Scavenger18/RepoPNP/Documentation/5_CAD/Assemblies/readme.txt

The assemblies include all files used to create the 3D CAD models of the feeders.
These were exported directly from the assemblies in the onshape project.
These include more pieces than need to be printed, such as screws and motor parts.
