Scavenger18/RepoPNP/Documentation/6_PCB-Daten/KiCAD/readme.txt

Frühere Versionen welche für Prototypen verwendet wurden sind nicht beigelegt.

Master_Board
- Das PCB für den Master für tinyK22, Kommunikation und Speisung.

Wall_F_V5
- Erweiterung aller Anpassungen und Boardform für die Projektabgabe. (Nicht getestet)

Wall_B_V5
- Die Seitenwand ohne elektrische Funktion. Stand Projektabgabe. 

PROTOTYPEN

Wall_F_V2
- Prototypenversion, Falscher uC Footprint.

Wall_F_V3
- Einbindung Encoderboard. Die Version welche für den Prototypenbau bei PCBWay bestellt wurde.

Wall_F_V4
- Die Umsetzung von diversen Änderungen. (Nicht getestet)

Enc_Board_V0
- Prototyp für Hallsensoren und Motormontage

Enc_Board_V1
- Prototyp für Lichtschranke EESX1350 Omron, Freistehend

Enc_Board_V2
- Prototyp für Lichtschranke EESX1350 Omron, Montage auf Wall_F

Enc_Board_v3
- Änderung des Footprints, Einbindung in Wall_F

H-Bridge_Board_V1
- Testaufbau für H-Brücke und Hallsensoren
