Scavenger18/RepoPNP/Documentation/6_PCB-Daten/CAM_Files/Sprocket/readme.txt

Folgend werden die in diesem Ordner vorhanden CAM-Dateien aufgelistet.
Die wall-Dateien können aus den jeweiligen KiCAD Projekten entnommen werden.

Sprocket_V2
- Innerer Bohrungsdurchmesser 3 mm
- Lichtschrankenbohrungen 23 mil

Sprocket_V3
- Innerer Bohrungsdurchmess 6.1 mm
- Lichtschrankenbohrungen 24 mil

Master_V1
- Stand Master PCB bei Projektabgabe

SeitenWand_V3
- Einseitig zu produzierendes PCB für die unbestückte Seitenwand des Feeders
