Scavenger18/RepoPNP/Documentation/4_3D-Daten/Normal settings.txt

Normal:
layer height: 0.1 mm
shell thickness: 0.4 mm
bottom/top thickness: 0.4 mm
fill density: 20%
