Scavenger18/RepoPNP/Documentation/5_CAD/Onshape_Projectlink.txt

Das OnShape Projekt kann unter dem Namen PnP-Feeder PAIND vom Benutzer s_h039 gefunden werden.

https://cad.onshape.com/documents/ed19ce3a0a41ba7e1ba1ae9e/w/841fa937de2a0d8fdfc5e5b4/e/0f40a22ce323581e1e362835
