Scavenger18/RepoPNP/CAD/images/Feeder_End_Radius.PNG

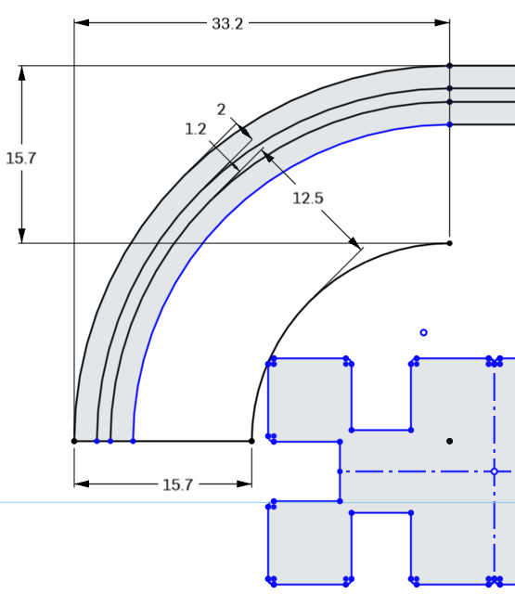
CAD/images/Feeder_End_Radius.PNG
