Scavenger18/RepoPNP/Datasheets/alu_schiene4020.jpg

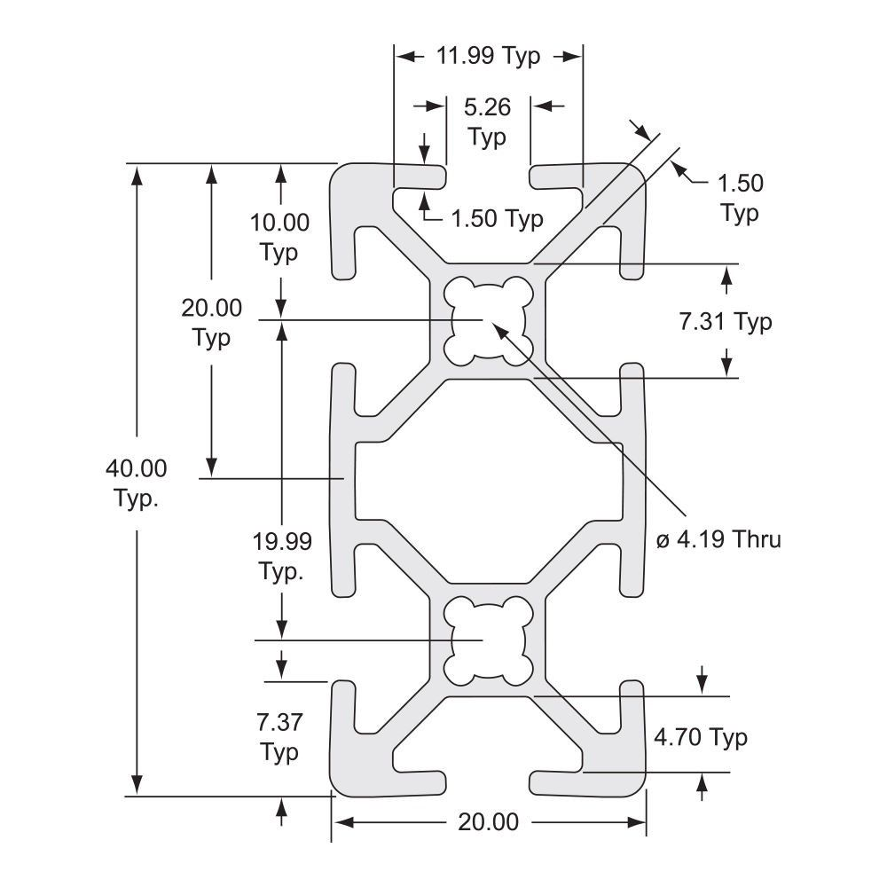
Datasheets/alu_schiene4020.jpg
