Scavenger18/RepoPNP/Datasheets/feedingfrenzy_schematic.png

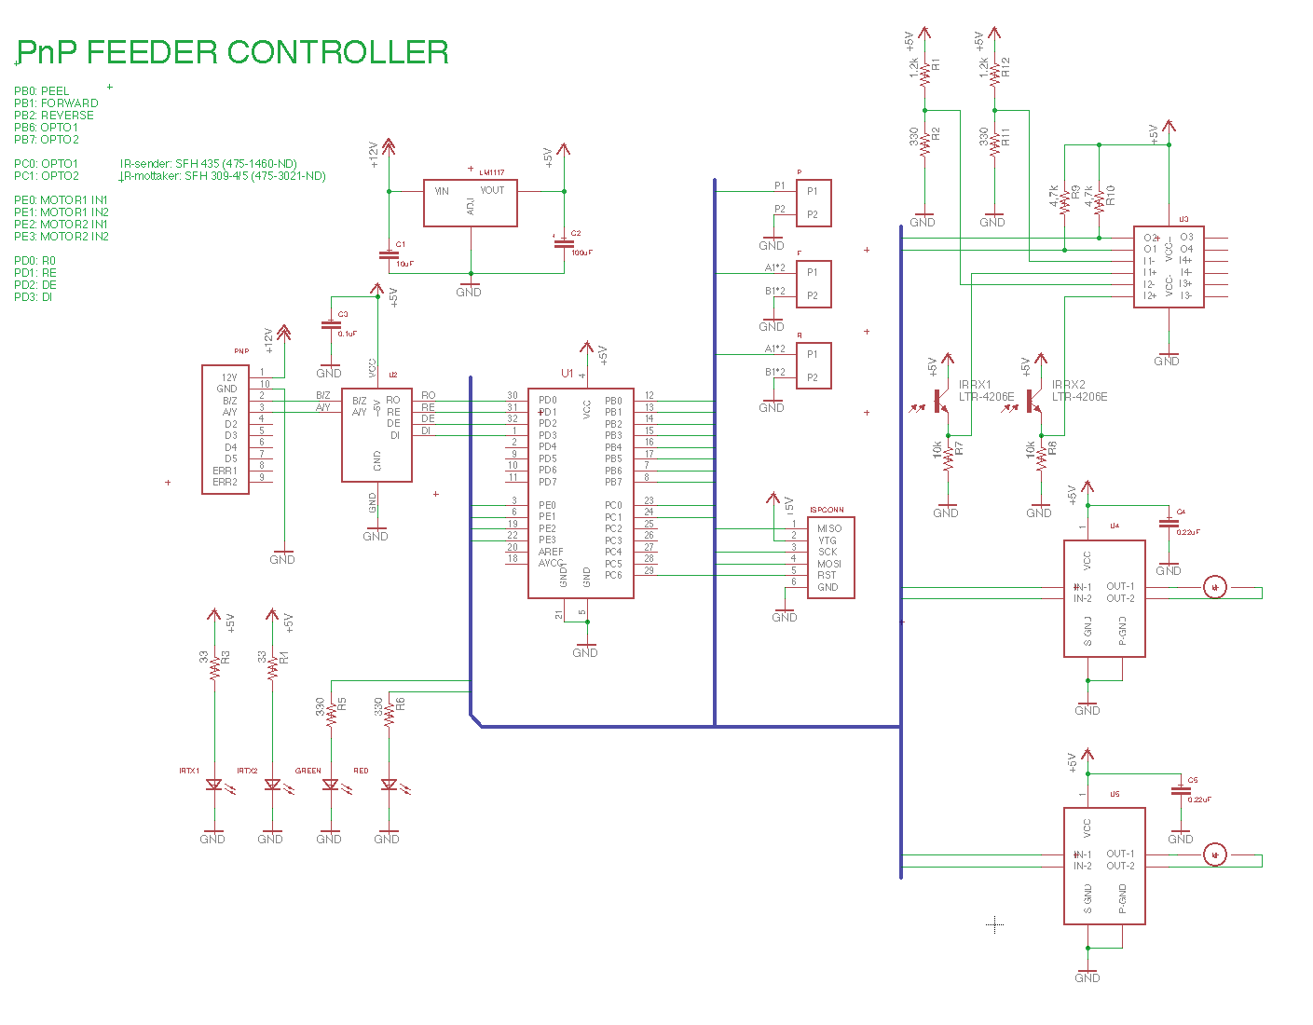
Datasheets/feedingfrenzy_schematic.png
