Scavenger18/RepoPNP/Datasheets/n20_gearmotor.jpg

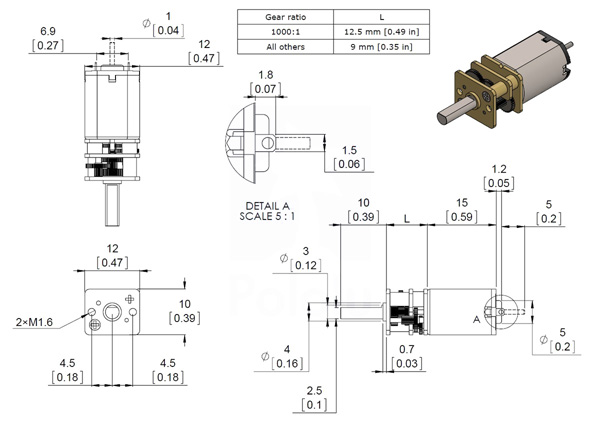
Datasheets/n20_gearmotor.jpg
