Scavenger18/RepoPNP/Documentation/1_Projektmanagement/Kostenzusammenstellung.xlsx

Sheet: Feeder
Kostenzusammenstellung PnP Feeder
Es wurden die Gesamtkosten für 50 Feeder berechnet, wenn alle Komponenten extern beschafft werden.
Die Unterschiede von Kosten zwischen den Feedern wurden gemittelt.
Die Preise wurden zwischen April und Juni 2018 von den Lieferantenwebseiten entnommen.
Exkl. Versandkosten
Position | Bereich | Artikelname | Bestellnummer | Lieferant | Anzahl pro Feeder | Anzahl 50 Feeder | Kosten 50 Feeder | Kosten Stk. Mengenrabatt | Bemerkung
1 | Elektro | 2x5 Pin Sockel (SWD) | 649-202112100010C4LF | Mouser | 1 | 50 | 29.70 | 0.594
2 | Elektro | DC-Getriebemotoren 150:1 | G4F3CD2FC5F5E2 | TinySine | 2 | 100 | 500.00 | 5.000
3 | Elektro | Detektorschalter | 667-ESE-22MH57 | Mouser | 1 | 50 | 25.90 | 0.518
4 | Elektro | Einweglichtschranke | 653-EESX1350 | Mouser | 1 | 50 | 70.00 | 1.400
5 | Elektro | Federleiste DIN 41651, Female | 143-12-170 | Distrelec | 2 | 100 | 114.00 | 1.140
6 | Elektro | Ferrit 330 Ohm | 810-MPZ2012S331A | Mouser | 1 | 50 | 4.95 | 0.099
7 | Elektro | H-Brücke DRV8835 | 595-DRV8835DSSR | Mouser | 1 | 50 | 75.50 | 1.510
8 | Elektro | Kondensator 100nF | 710-885012207098 | Mouser | 9 | 450 | 18.90 | 0.042
9 | Elektro | Kondensator 1uF | 77-VJ0805Y105MXQTBC | Mouser | 1 | 50 | 1.90 | 0.038
10 | Elektro | Kondensator 2.2uF | 810-C2012JB1A225K08A | Mouser | 3 | 150 | 7.65 | 0.051
11 | Elektro | Kondensator 220uF | 140-VZL221M1CTR-0607 | Mouser | 2 | 100 | 13.60 | 0.136
12 | Elektro | Kondensator 330nF | 77-VJ0805Y334MXJTBC | Mouser | 2 | 100 | 3.10 | 0.031
13 | Elektro | LDO Spannungsregler | 579-TC1262-3.3VDBTR | Mouser | 1 | 50 | 22.35 | 0.447
14 | Elektro | LED Orange | 720-LOR976-PS-1 | Mouser | 1 | 50 | 9.35 | 0.187
15 | Elektro | Mikrokontroller MK20 | 841-MK20DX128VFT5 | Mouser | 1 | 50 | 229.50 | 4.590
16 | Elektro | Quarz 32.768kHz | 520-.327-CDX-1082 | Mouser | 1 | 50 | 26.35 | 0.527
17 | Elektro | Quarz 8 MHz | 774-406I35D08M00000 | Mouser | 1 | 50 | 28.95 | 0.579
18 | Elektro | Shottky Dioden | 821-BAS40-05 | Mouser | 1 | 50 | 15.50 | 0.310
19 | Elektro | SMD Taster | 612-LL3301NF065QG | Mouser | 3 | 150 | 69.00 | 0.460
20 | Elektro | Stiftleiste DIN 41651, Male | 143-65-383 | Distrelec | 2 | 100 | 123.00 | 1.230
21 | Elektro | Transistor BC847 | 863-BC847CLT1G | Mouser | 1 | 50 | 5.00 | 0.100
22 | Elektro | Widerstand 0 Ohm | 300-56-850 | Distrelec | 2 | 100 | 1.42 | 0.014
23 | Elektro | Widerstand 10 kOhm | 300-56-854 | Distrelec | 2 | 100 | 1.42 | 0.014
24 | Elektro | Widerstand 100 kOhm | 300-56-855 | Distrelec | 3 | 150 | 2.13 | 0.014
25 | Elektro | Widerstand 100 Ohm | 300-38-263 | Distrelec | 1 | 50 | 0.71 | 0.014
26 | Elektro | Widerstand 4.7 kOhm | 300-56-891 | Distrelec | 1 | 50 | 0.71 | 0.014
27 | Elektro | Widerstand 47 Ohm | 300-56-894 | Distrelec | 1 | 50 | 0.71 | 0.014
28 | Elektro | Widerstand 470 Ohm | 300-56-890 | Distrelec | 1 | 50 | 0.71 | 0.014
29 | mech. | Abstandsbolzen | *siehe Bemerkung | Distrelec | 2 | 100 | 50.00 | 0.500 | Gemittelter Preis
30 | mech. | Distanzstück 15 mm | 300-70-978 | Distrelec | 1 | 50 | 66.50 | 1.330
31 | mech. | PLA Material | ~28 gramm/feeder | 3d-printerstore | 1 | 50 | 31.50 | 0.630 | 22.50/kg
32 | PCB | PCB Feeder |  | PCBWay | 1 | 50 | 142.00 | 2.840
33 | PCB | PCB Seitenwand |  | PCBWay | 1 | 50 | 142.00 | 2.840
34 | PCB | Sprocket |  | PCBWay | 1 | 50 | 43.00 | 0.860
 |  |  |  |  |  | Total | 1877.01 | 37.5402

Sheet: Master
Kostenzusammenstellung PnP Master-Board
Es wurden die Gesamtkosten für 1 Master berechnet.
Das tinyK22 welches benötigt wird ist in dieser Zusammenstellung nicht miteinbezogen.
Position | Bereich | Artikelname | Bestellnummer | Lieferant | Anzahl pro Master | Kosten pro Stück | Kosten pro Master | Bemerkung
1 | Elektro | Stiftleiste DIN 41651, Male | 143-65-383 | Distrelec | 2 | 1.58 | 3.16
1 | Elektro | DC Power Jack, Female, 6.4 mm | 300-09-339 | Distrelec | 1 | 2.05 | 2.05
1 | PCB | PCB Master |  | PCBWay | 1 | 0.5 | 0.5 | 10 Stück
1 | mech. | PLA Material | ~21 gramm/master | 3d-printerstore | 1 | 0.4725 | 0.4725 | 22.50/kg
 |  |  |  |  |  | Total | 6.1825
