Scavenger18/RepoPNP/Documentation/1_Projektmanagement/Risikomanagement.xlsx

Sheet: Risikoliste
Risikoanalyse PnP Feeder
Titel | Beschreibung | Schadensart | W.-keit | Schadenshöhe | Risikoklasse | Massnahmen
Terminplan | Schlechte Zeiteinteilung | Zeitverlust | 30% | 20% | tragbar | Zeitpuffer einplanen
Dokumentation | Dokumentation/Arbeitsjournal vernachlässigen | Datenverlust | 30% | 40% | hoch | Jede Woche nachführen
Wartezeiten | Wartezeiten auf Bauteil-Bestellungen | Zeitverlust | 40% | 50% | sehr hoch | früh bestellen
falsche Strategie | Falsche Herangehensweise | Zeitverlust | 10% | 50% | hoch | Wöchentliche Sitzungen
mechanisches Konzept | Grobe Fehler in Prototypen | Konzeptänderung | 40% | 60% | sehr hoch | Konzeptbesprechung, ausführliche Tests
elektrisches Konzept | Grobe Fehler in Prototypen | Konzeptänderung | 30% | 60% | sehr hoch | Konzeptbesprechung, ausführliche Tests
Entwicklung PCB | Fehler in bestellten Leiterplatten | Zeitverlust | 20% | 50% | hoch | Vorgänger testen und Änderungen prüfen
Schritterkennung | Schrittverlust | nichterfüllung Vorgabe | 20% | 70% | sehr hoch | grosse Bohrungen, ausführliche Tests
3D Getriebe | Qualität und Funktion ungenügend | Konzeptänderung | 20% | 40% | hoch | früh testen und bestätigen
Kommunikation | Kommunikation an Feederbank scheitert | nichterfüllung Vorgabe | 20% | 50% | hoch | Distanzen kurz halten
Ungenauigkeit | mechanische Toleranzen führen zu ungenauen Schritte | nichterfüllung Vorgabe | 50% | 30% | sehr hoch | höchste Druckqualität verwenden
Bauteilverlust | Bauteile werden aus der Führung gespickt | Konzeptänderung | 20% | 30% | tragbar | Peeler sanft fahren, Deckel

Sheet: Matrixdefinition
Matrixaufbau
Wahrscheinlichkeit | Schadenshöhe | Risikoklasse | Einstufung | Matrix | 10 | 20 | 30 | 40 | 50 | 60 | 70 | 80 | 90 | 100
100% | 10% | 10 | kritisch | 10 | 1 | 2 | 3 | 4 | 5 | 6 | 7 | 8 | 9 | 10
90% | 20% | 9 | kritisch | 20 | 2 | 3 | 4 | 5 | 6 | 7 | 8 | 9 | 10 | 10
80% | 30% | 8 | sehr hoch | 30 | 3 | 4 | 5 | 6 | 7 | 8 | 9 | 10 | 10 | 10
70% | 40% | 7 | sehr hoch | 40 | 4 | 5 | 6 | 7 | 8 | 8 | 10 | 10 | 10 | 10
60% | 50% | 6 | hoch | 50 | 5 | 6 | 7 | 8 | 8 | 10 | 10 | 10 | 10 | 10
50% | 60% | 5 | hoch | 60 | 6 | 7 | 8 | 8 | 10 | 10 | 10 | 10 | 10 | 10
40% | 70% | 4 | tragbar | 70 | 7 | 8 | 9 | 10 | 10 | 10 | 10 | 10 | 10 | 10
30% | 80% | 3 | tragbar | 80 | 8 | 9 | 10 | 10 | 10 | 10 | 10 | 10 | 10 | 10
20% | 90% | 2 | klein | 90 | 9 | 10 | 10 | 10 | 10 | 10 | 10 | 10 | 10 | 10
10% | 100% | 1 | vernachlässigbar | 100 | 10 | 10 | 10 | 10 | 10 | 10 | 10 | 10 | 10 | 10
