Scavenger18/RepoPNP/Documentation/4_3D-Daten/0_Common/Normal/Sproc_Bot_Motor.stl

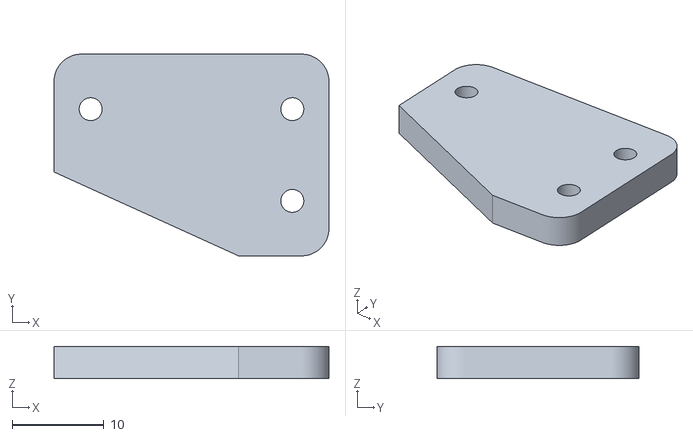
[picture p82: CAD file, 2018-06-06]
Documentation/4_3D-Daten/0_Common/Normal/Sproc_Bot_Motor.stl
30.0 x 22.0 x 3.50
