Scavenger18/RepoPNP/Documentation/4_3D-Daten/1_8MM/TapeGear_10_8MM.stl

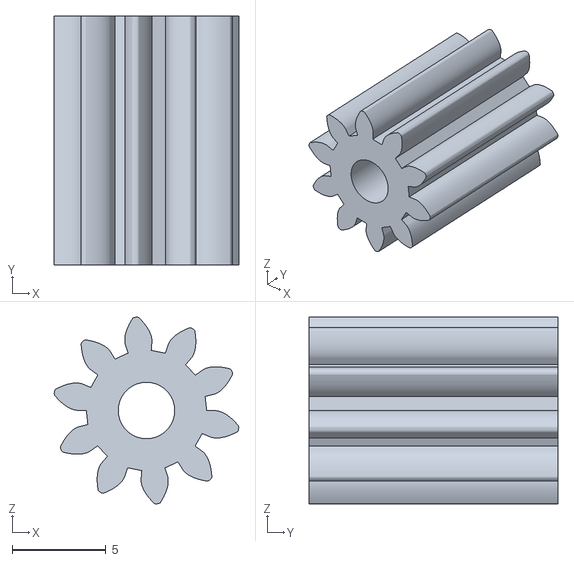
[picture p83: CAD file, 2018-06-06]
Documentation/4_3D-Daten/1_8MM/TapeGear_10_8MM.stl
9.83 x 13.3 x 9.95
