Scavenger18/RepoPNP/Documentation/4_3D-Daten/2_12MM/TapeGear_11_12MM.stl

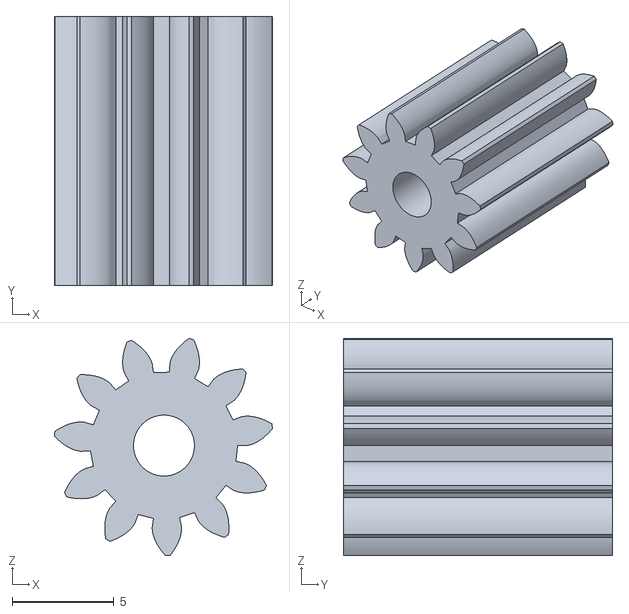
[picture p84: CAD file, 2018-06-06]
Documentation/4_3D-Daten/2_12MM/TapeGear_11_12MM.stl
10.8 x 13.3 x 10.7
