Scavenger18/RepoPNP/Documentation/4_3D-Daten/3_16MM/TapeGear_10_16mm.stl

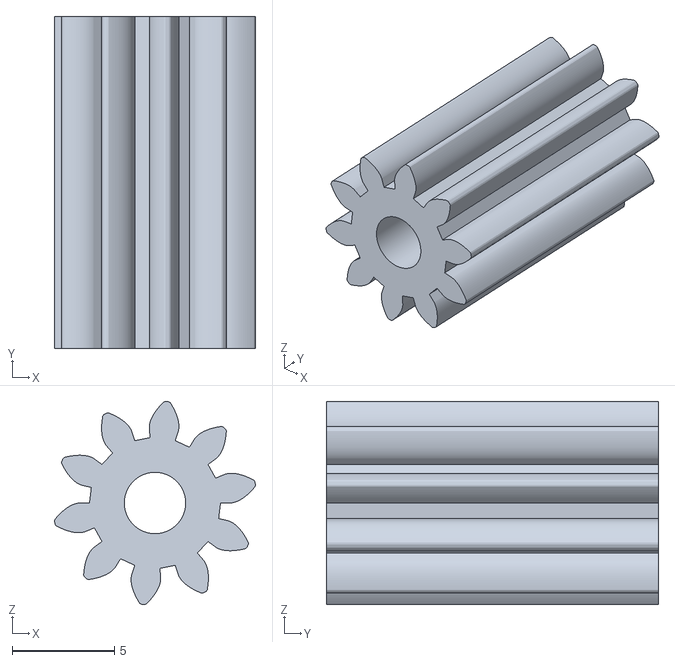
[picture p85: CAD file, 2018-06-06]
Documentation/4_3D-Daten/3_16MM/TapeGear_10_16mm.stl
9.84 x 16.2 x 9.94
