Scavenger18/RepoPNP/Documentation/4_3D-Daten/4_24MM/FrontWall_24MM.stl

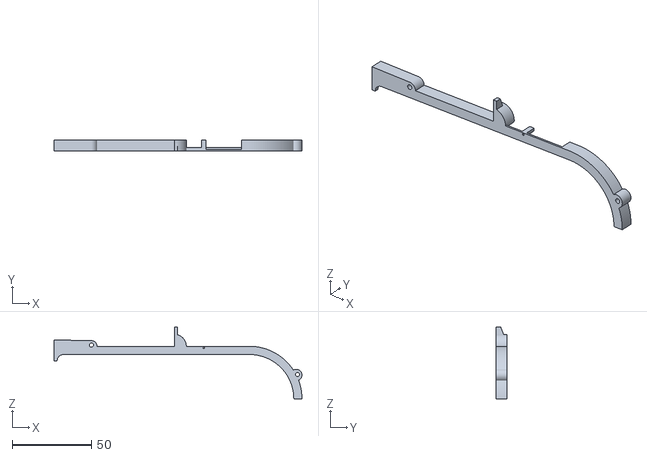
[picture p86: CAD file, 2018-06-06]
Documentation/4_3D-Daten/4_24MM/FrontWall_24MM.stl
156.6 x 7.00 x 45.3
