Scavenger18/RepoPNP/Documentation/4_3D-Daten/5_Mastergehäuse/MasterBox_Top.stl

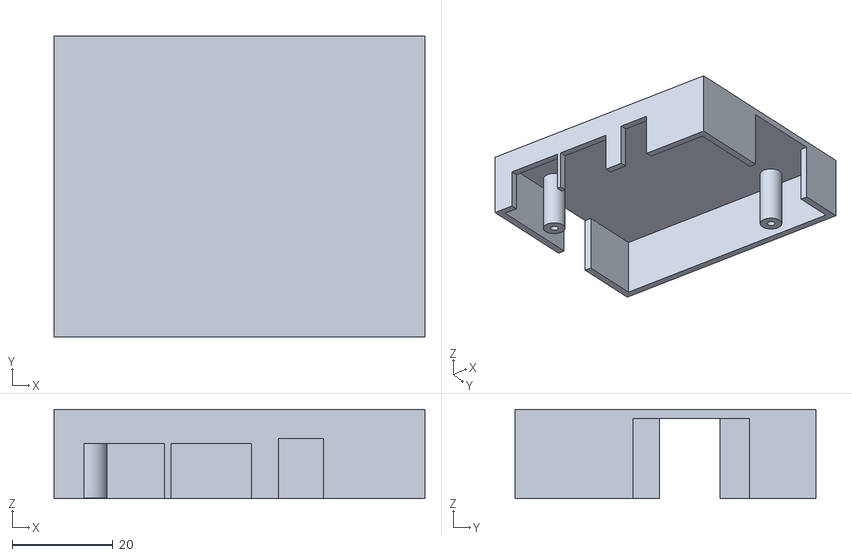
[picture p87: CAD file, 2018-06-06]
Documentation/4_3D-Daten/5_Mastergehäuse/MasterBox_Top.stl
73.5 x 59.6 x 17.7
