Scavenger18/RepoPNP/Documentation/5_CAD/DXF/Sprocket_62.dxf

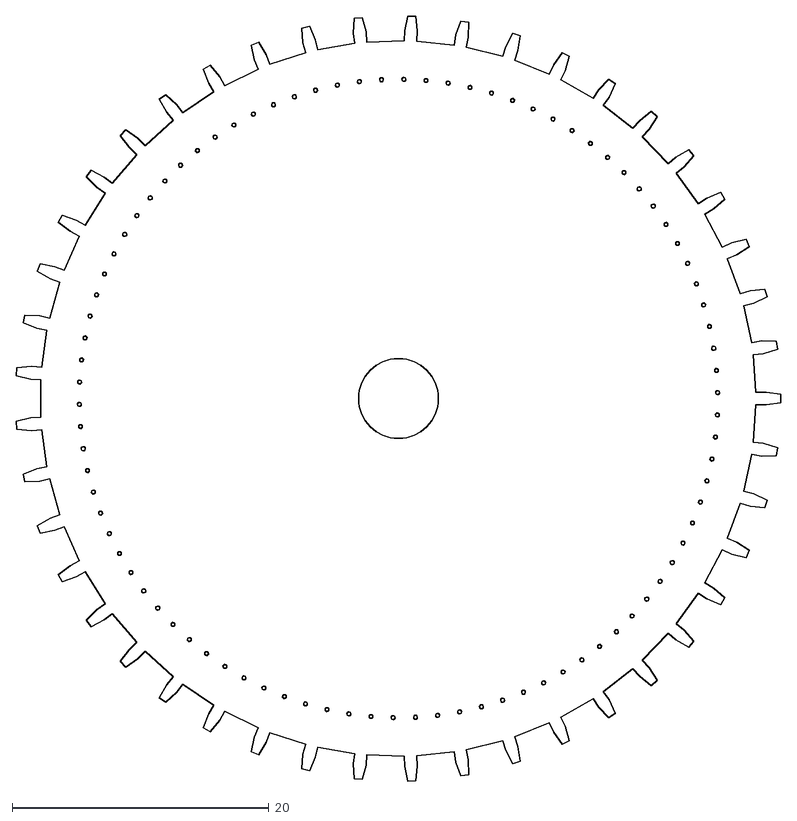
[picture p88: CAD file, 2018-06-06]
Documentation/5_CAD/DXF/Sprocket_62.dxf
59.5 x 59.5
