Scavenger18/RepoPNP/Documentation/4_3D-Daten/0_Common/Fine/SprocWorm_L.stl

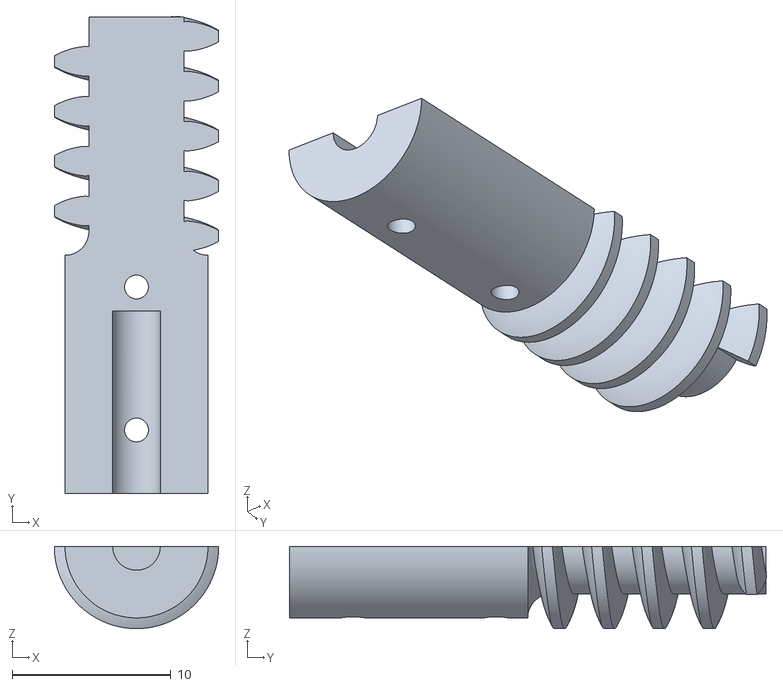
[picture p89: CAD file, 2018-06-06]
Documentation/4_3D-Daten/0_Common/Fine/SprocWorm_L.stl
10.4 x 30.0 x 5.18
