Scavenger18/RepoPNP/Documentation/4_3D-Daten/1_8MM/FrontWall_8MM.stl

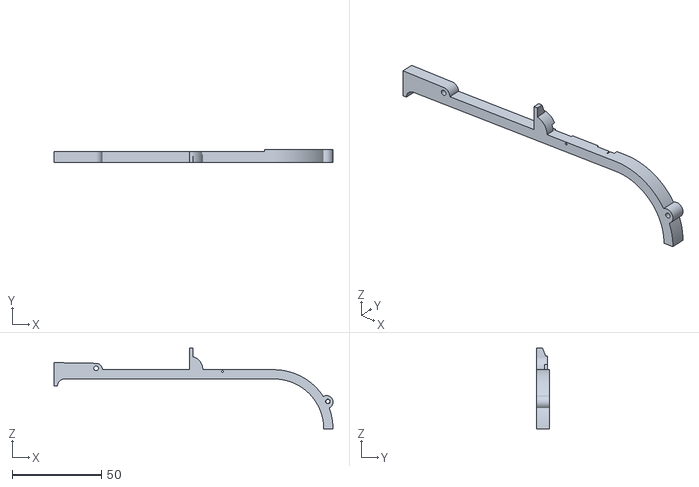
[picture p91: CAD file, 2018-06-06]
Documentation/4_3D-Daten/1_8MM/FrontWall_8MM.stl
156.6 x 7.50 x 45.3
