Scavenger18/RepoPNP/Documentation/4_3D-Daten/2_12MM/FrontWall_12MM.stl

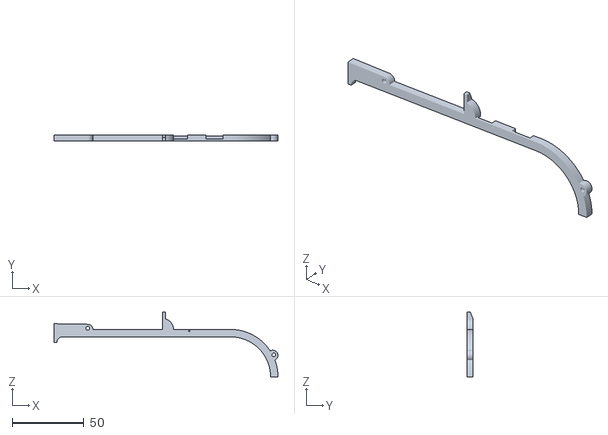
[picture p92: CAD file, 2018-06-06]
Documentation/4_3D-Daten/2_12MM/FrontWall_12MM.stl
156.6 x 4.50 x 45.3
