Scavenger18/RepoPNP/Documentation/4_3D-Daten/3_16MM/BackWall_16MM.stl

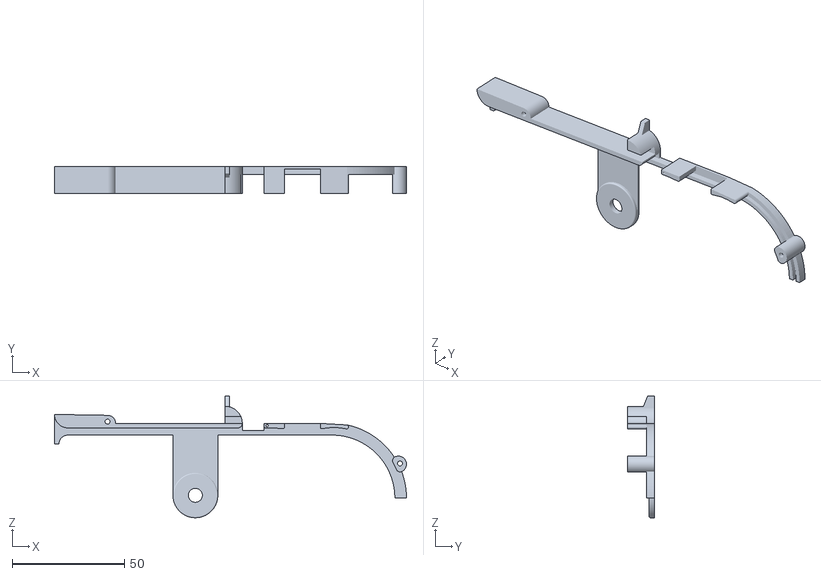
[picture p93: CAD file, 2018-06-06]
Documentation/4_3D-Daten/3_16MM/BackWall_16MM.stl
156.6 x 11.8 x 54.1
