Scavenger18/RepoPNP/Documentation/4_3D-Daten/4_24MM/TG_11_24mm.stl

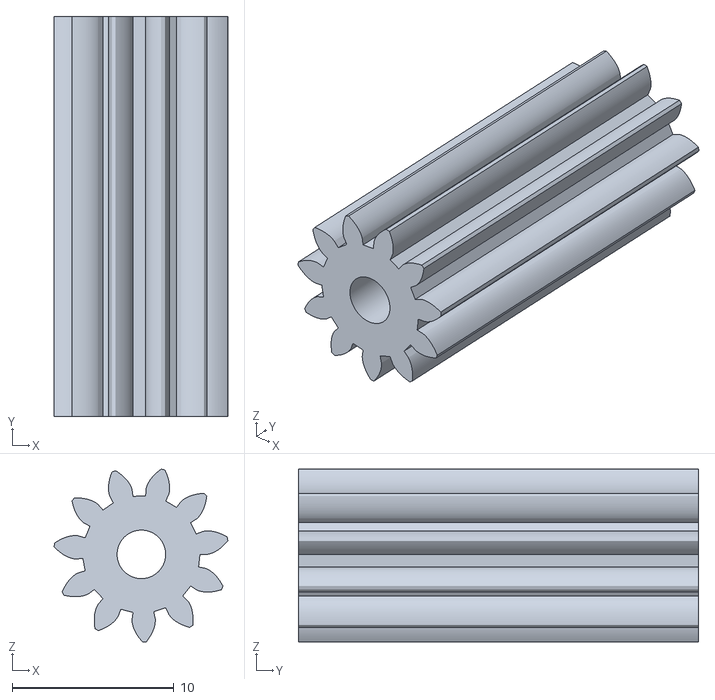
[picture p94: CAD file, 2018-06-06]
Documentation/4_3D-Daten/4_24MM/TG_11_24mm.stl
10.8 x 24.8 x 10.7
