Scavenger18/RepoPNP/Documentation/4_3D-Daten/5_Mastergehäuse/MasterBox_Bottom.stl

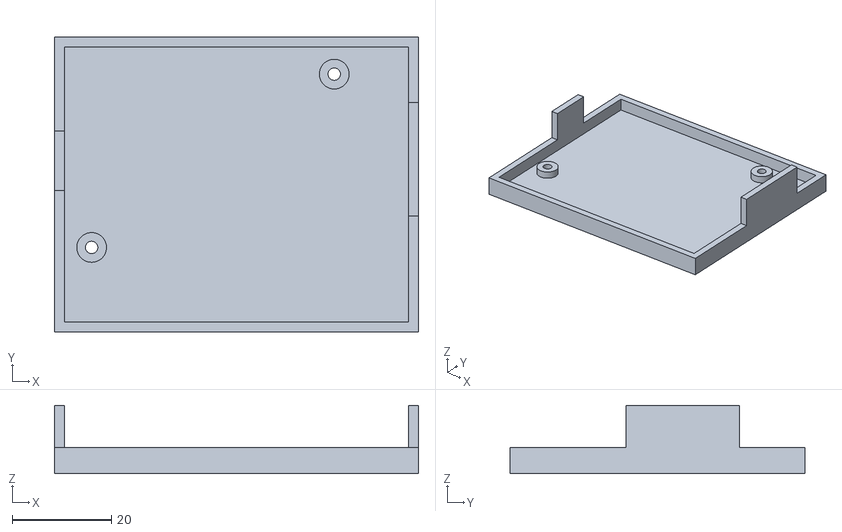
[picture p95: CAD file, 2018-06-06]
Documentation/4_3D-Daten/5_Mastergehäuse/MasterBox_Bottom.stl
73.5 x 59.6 x 13.8
