Scavenger18/RepoPNP/Documentation/5_CAD/DXF/FeederBank_Board.dxf

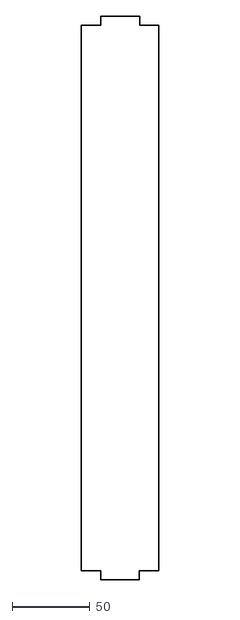
[picture p96: CAD file, 2018-06-06]
Documentation/5_CAD/DXF/FeederBank_Board.dxf
50.0 x 362.0
