Scavenger18/RepoPNP/Documentation/4_3D-Daten/0_Common/Fine/TapeWorm_R.stl

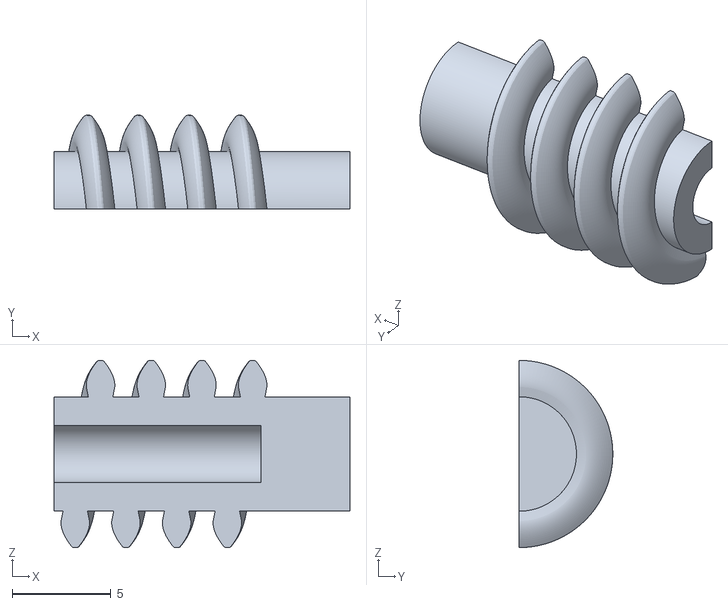
[picture p97: CAD file, 2018-06-06]
Documentation/4_3D-Daten/0_Common/Fine/TapeWorm_R.stl
15.0 x 4.74 x 9.49
