Scavenger18/RepoPNP/Documentation/4_3D-Daten/0_Common/Normal/Tape_Spacer.stl

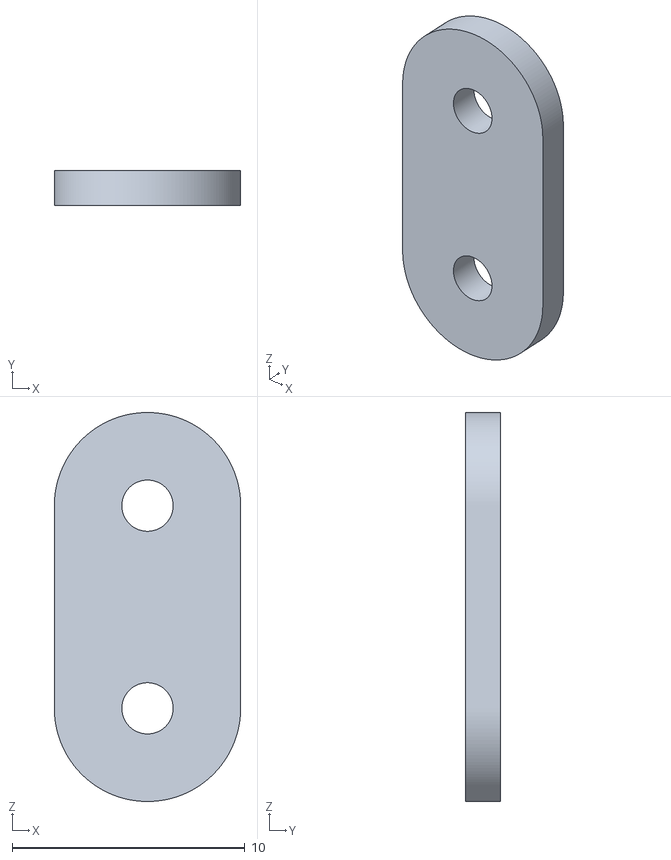
[picture p98: CAD file, 2018-06-06]
Documentation/4_3D-Daten/0_Common/Normal/Tape_Spacer.stl
8.00 x 1.50 x 16.7
