Scavenger18/RepoPNP/Documentation/4_3D-Daten/1_8MM/BackWall_8MM.stl

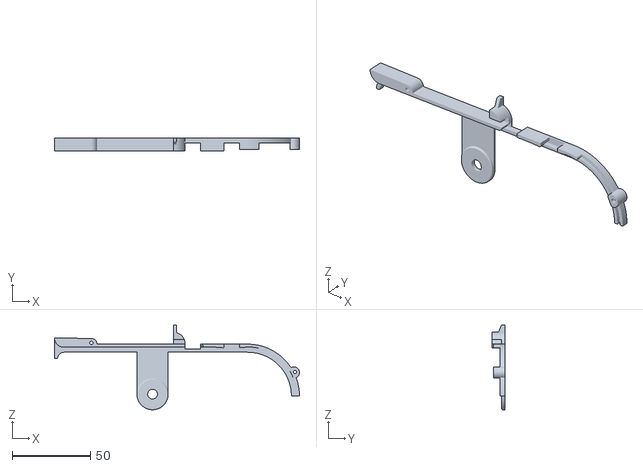
[picture p99: CAD file, 2018-06-06]
Documentation/4_3D-Daten/1_8MM/BackWall_8MM.stl
156.6 x 8.60 x 54.1
