Scavenger18/RepoPNP/Documentation/4_3D-Daten/2_12MM/BackWall_12MM.stl

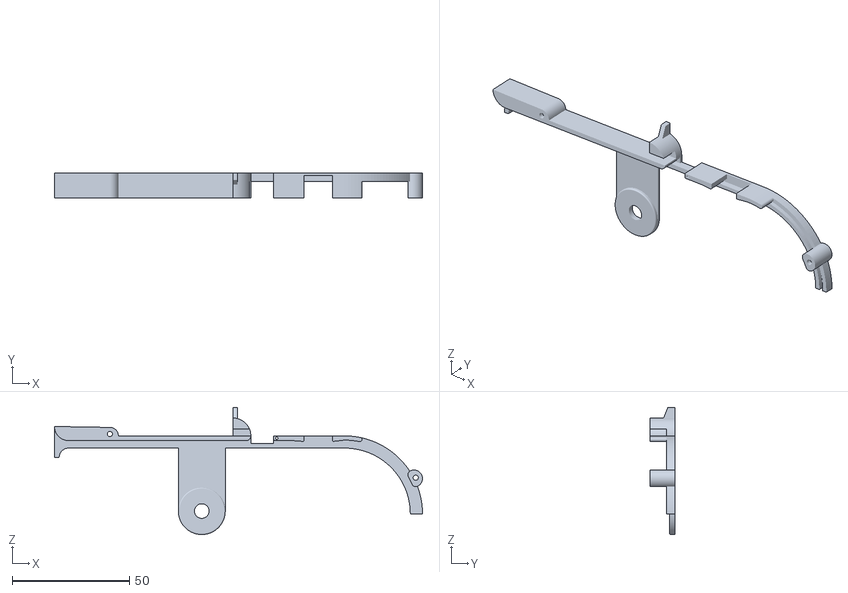
[picture p100: CAD file, 2018-06-06]
Documentation/4_3D-Daten/2_12MM/BackWall_12MM.stl
156.6 x 10.5 x 54.1
