Scavenger18/RepoPNP/Documentation/4_3D-Daten/3_16MM/TapeGear_11_16mm.stl

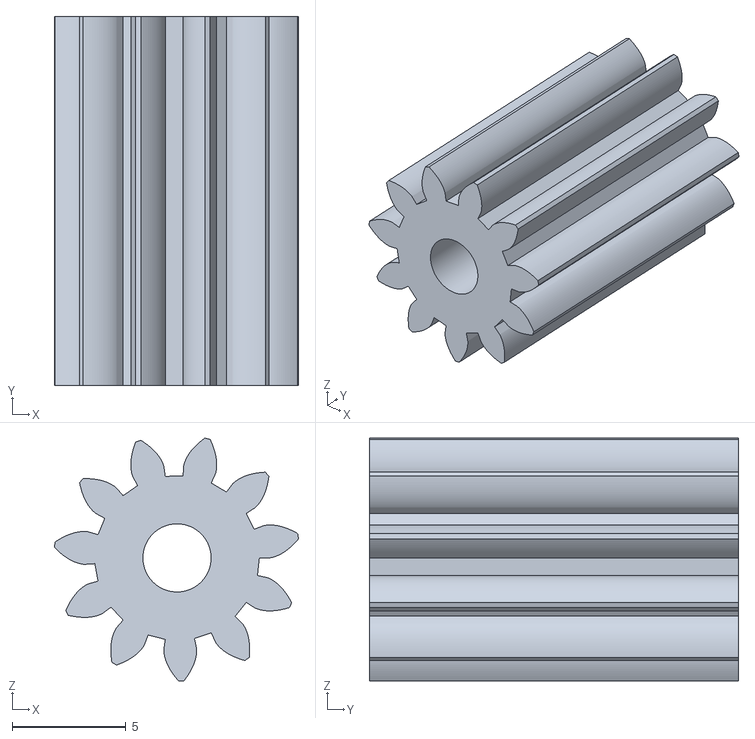
[picture p101: CAD file, 2018-06-06]
Documentation/4_3D-Daten/3_16MM/TapeGear_11_16mm.stl
10.8 x 16.2 x 10.7
