Scavenger18/RepoPNP/Documentation/4_3D-Daten/4_24MM/Distance_24.stl

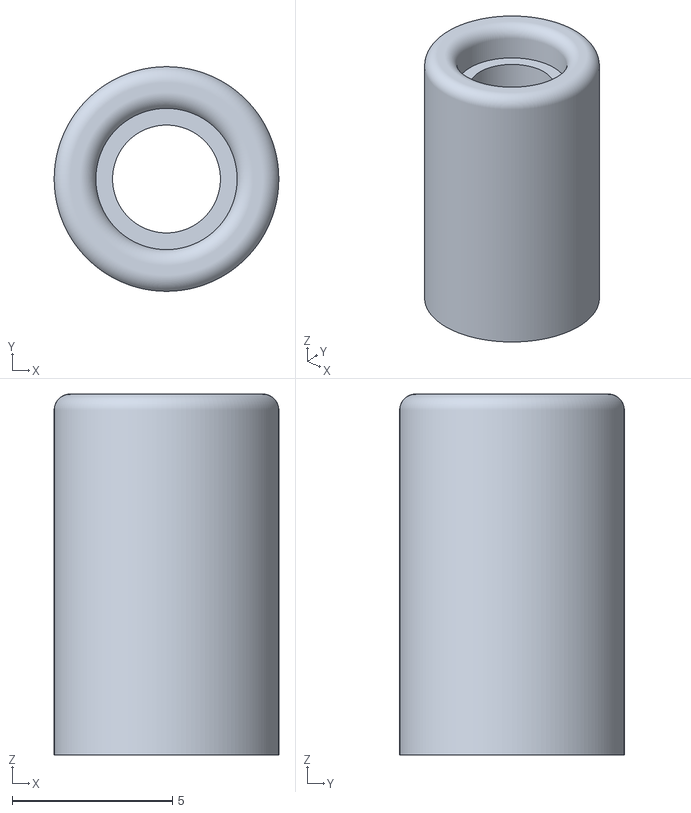
[picture p102: CAD file, 2018-06-06]
Documentation/4_3D-Daten/4_24MM/Distance_24.stl
7.00 x 7.00 x 11.2
