Scavenger18/RepoPNP/Documentation/5_CAD/DXF/FeederBank_Wall.dxf

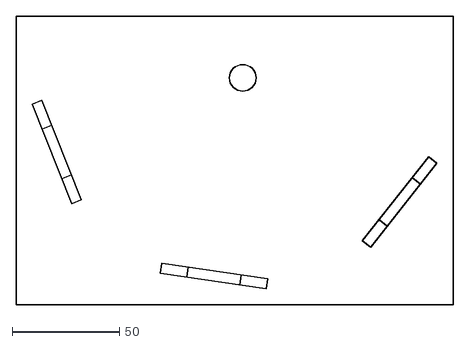
[picture p103: CAD file, 2018-06-06]
Documentation/5_CAD/DXF/FeederBank_Wall.dxf
204.2 x 135.0
