Scavenger18/RepoPNP/Documentation/4_3D-Daten/0_Common/Normal/Sproc_Top_Motor.stl

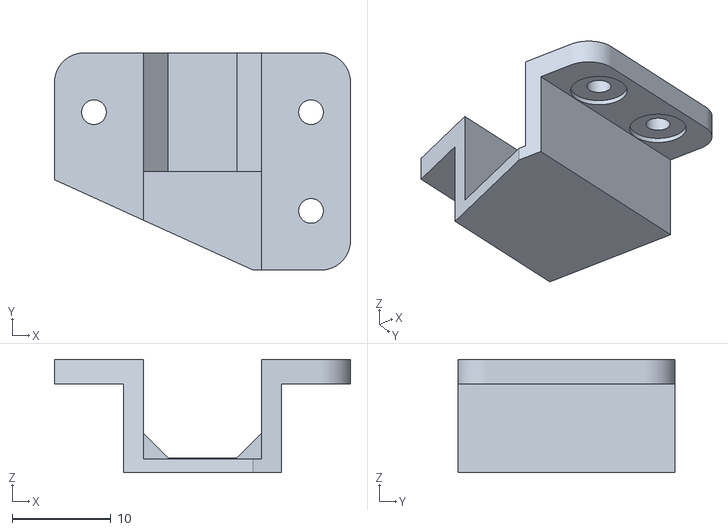
[picture p104: CAD file, 2018-06-06]
Documentation/4_3D-Daten/0_Common/Normal/Sproc_Top_Motor.stl
30.0 x 22.0 x 11.5
