Scavenger18/RepoPNP/Documentation/4_3D-Daten/3_16MM/FrontWall_16MM.stl

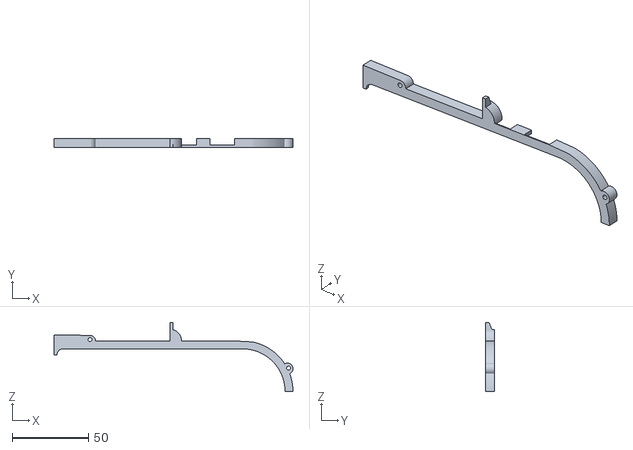
[picture p105: CAD file, 2018-06-06]
Documentation/4_3D-Daten/3_16MM/FrontWall_16MM.stl
156.6 x 6.20 x 45.3
