Scavenger18/RepoPNP/Documentation/4_3D-Daten/4_24MM/24mm_Spacer_1.stl

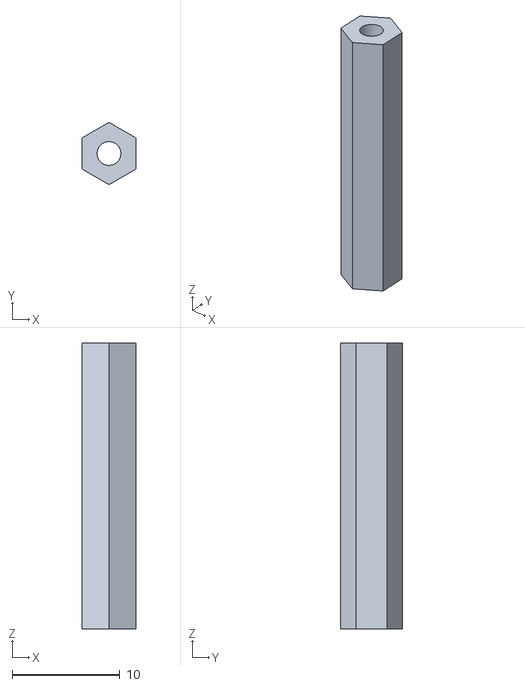
[picture p106: CAD file, 2018-06-06]
Documentation/4_3D-Daten/4_24MM/24mm_Spacer_1.stl
5.00 x 5.77 x 26.5
