Scavenger18/RepoPNP/Documentation/5_CAD/DXF/PCB_Sketch_F.dxf

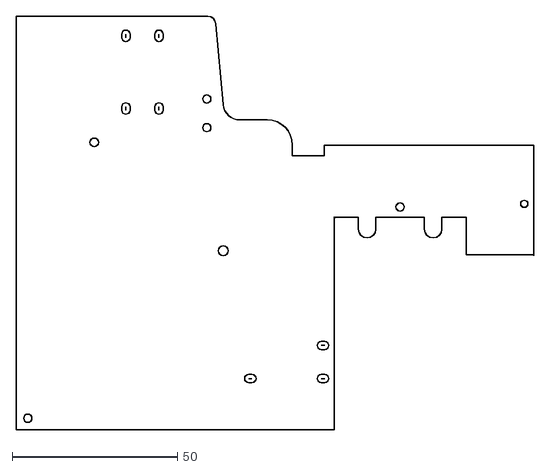
[picture p107: CAD file, 2018-06-06]
Documentation/5_CAD/DXF/PCB_Sketch_F.dxf
156.6 x 125.2
