Scavenger18/RepoPNP/Documentation/4_3D-Daten/0_Common/Fine/SprocGear_30.stl

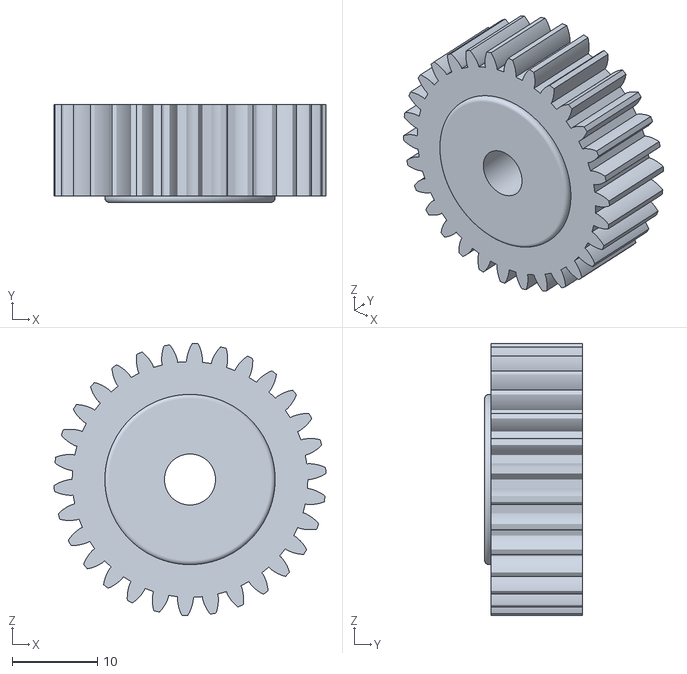
[picture p108: CAD file, 2018-06-06]
Documentation/4_3D-Daten/0_Common/Fine/SprocGear_30.stl
32.0 x 11.5 x 32.0
