Scavenger18/RepoPNP/Documentation/4_3D-Daten/3_16MM/Distance_16.stl

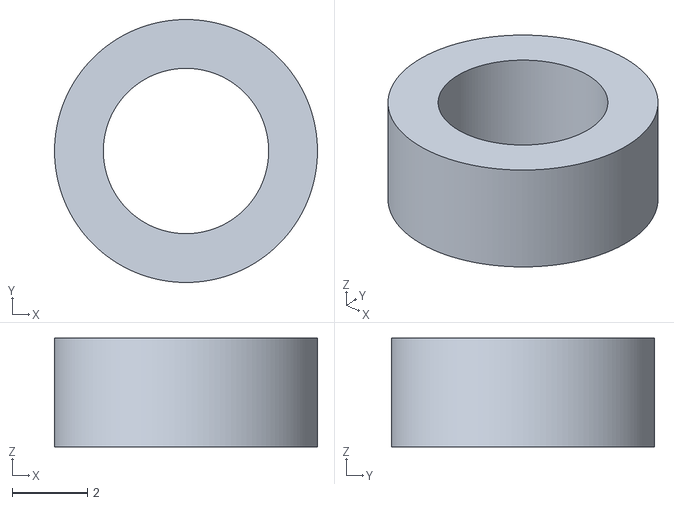
[picture p110: CAD file, 2018-06-06]
Documentation/4_3D-Daten/3_16MM/Distance_16.stl
7.00 x 7.00 x 2.90
