Scavenger18/RepoPNP/Documentation/4_3D-Daten/4_24MM/BackWall_24MM.stl

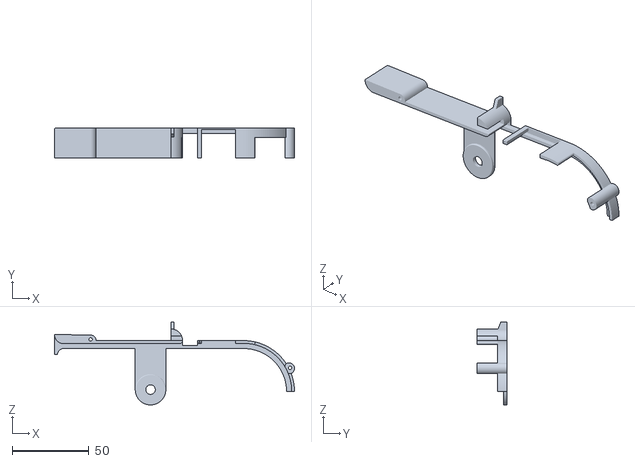
[picture p111: CAD file, 2018-06-06]
Documentation/4_3D-Daten/4_24MM/BackWall_24MM.stl
156.6 x 19.5 x 54.1
