Scavenger18/RepoPNP/Documentation/5_CAD/DXF/PCB_Sketch_B.dxf

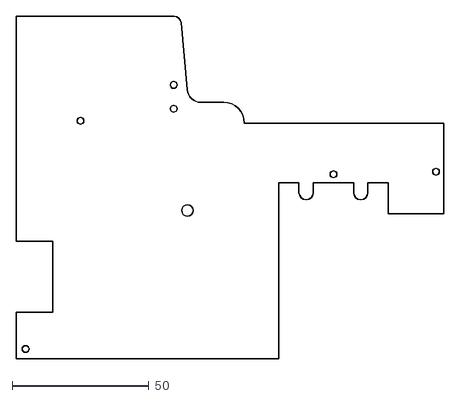
[picture p112: CAD file, 2018-06-06]
Documentation/5_CAD/DXF/PCB_Sketch_B.dxf
156.6 x 125.2
