Scavenger18/RepoPNP/Documentation/4_3D-Daten/4_24MM/TG_10_24mm.stl

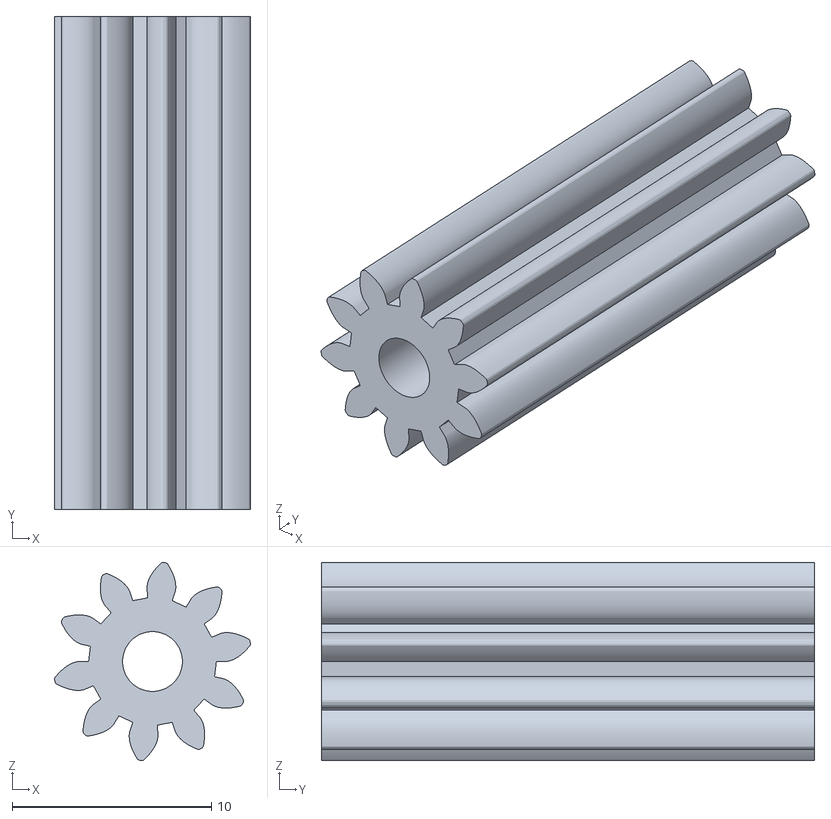
[picture p113: CAD file, 2018-06-06]
Documentation/4_3D-Daten/4_24MM/TG_10_24mm.stl
9.84 x 24.8 x 9.94
