Scavenger18/RepoPNP/(list of files, cad)

Other CAD files:
Datasheets/gg_gear_30.dxf
Documentation/4_3D-Daten/0_Common/Fine/SprocWorm_R.stl
