Scavenger18/RepoPNP/Documentation/2_Dokumente/Schema_Feeder.pdf

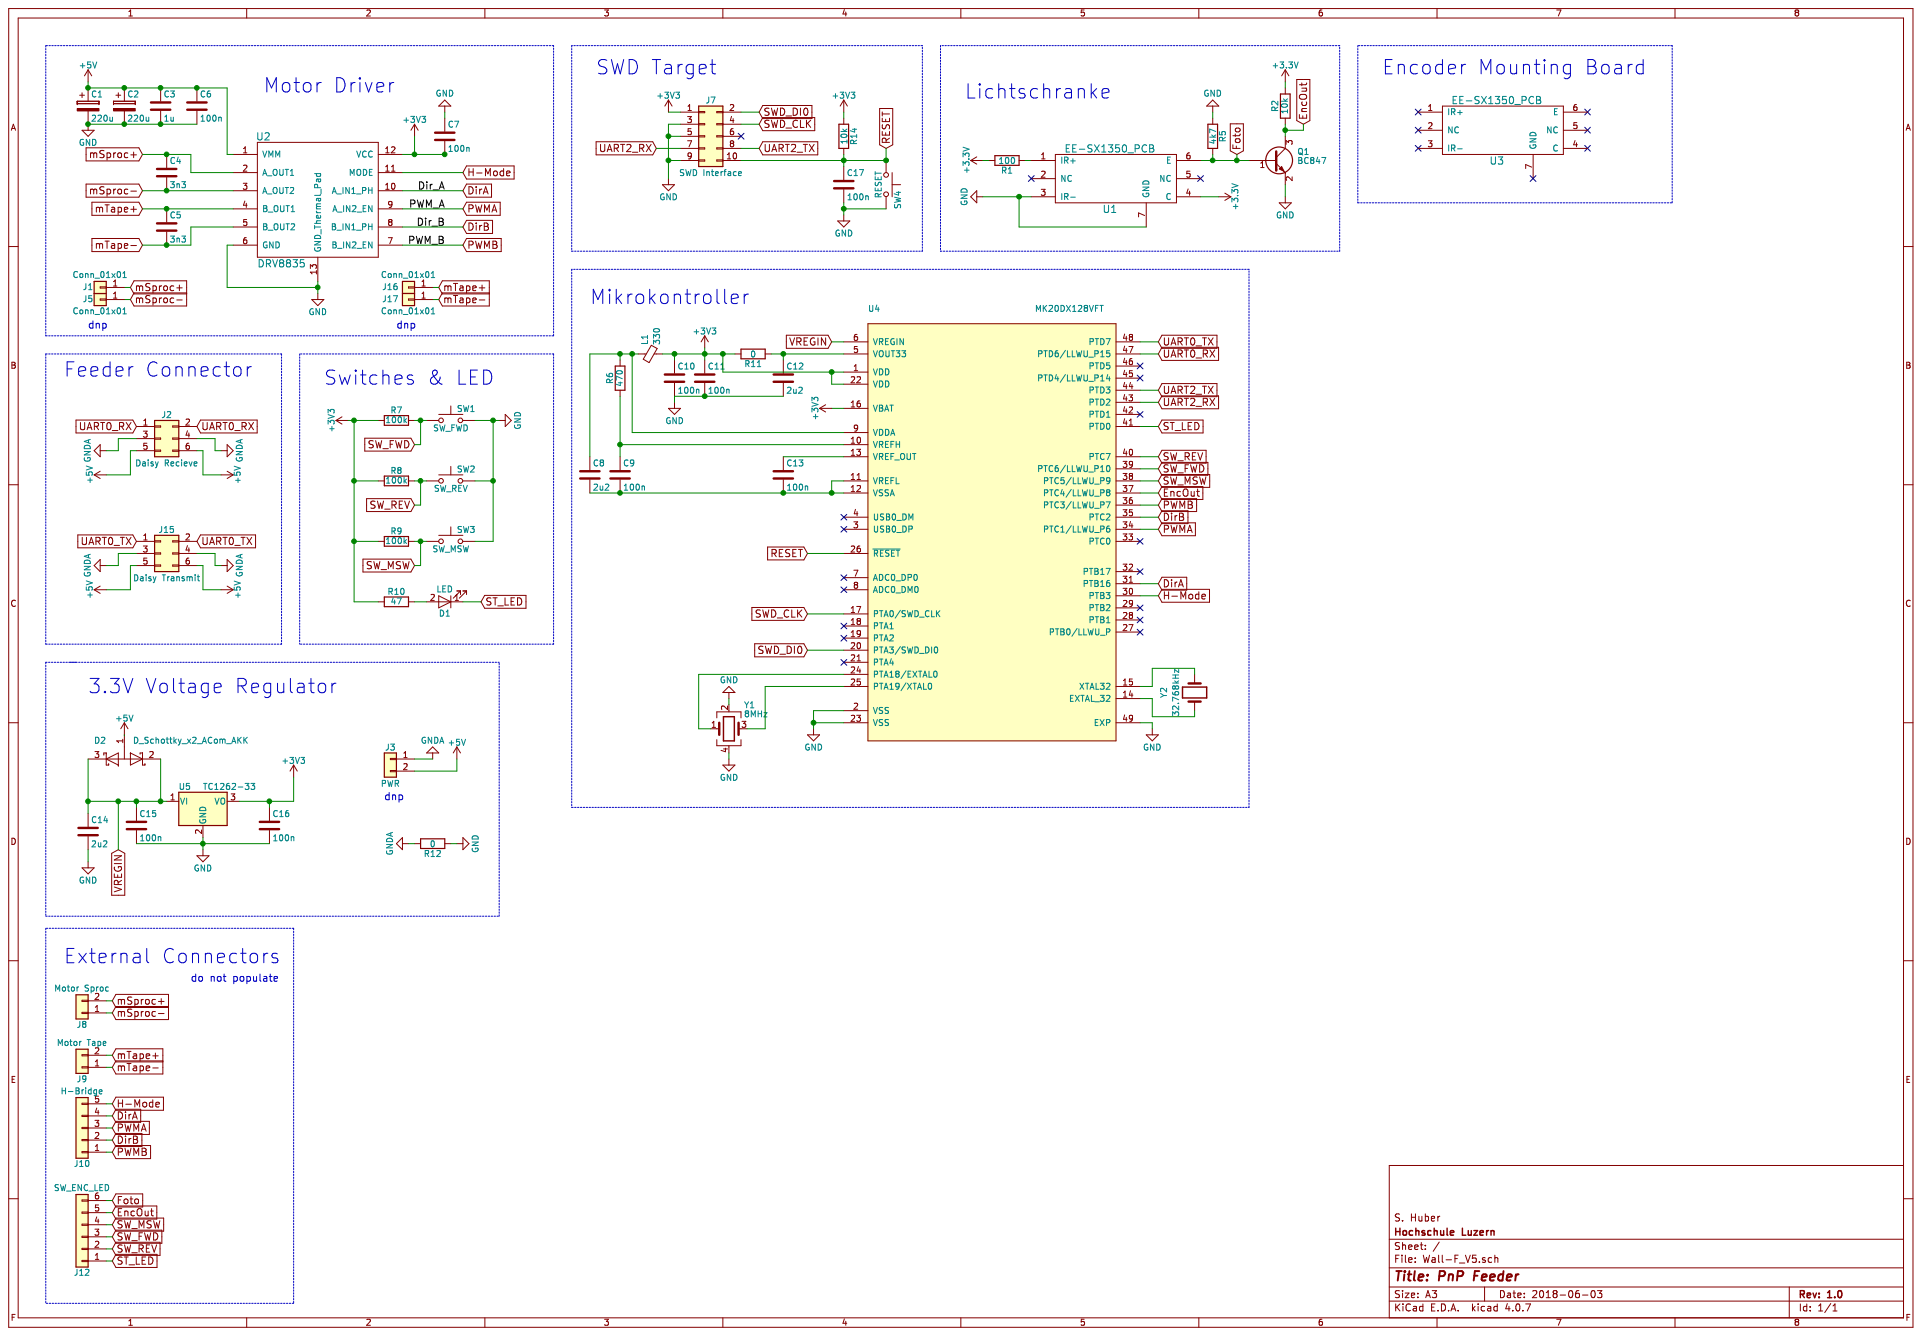
[picture p159: page 1]
