Scavenger18/RepoPNP/Documentation/2_Dokumente/Schema_Master.pdf

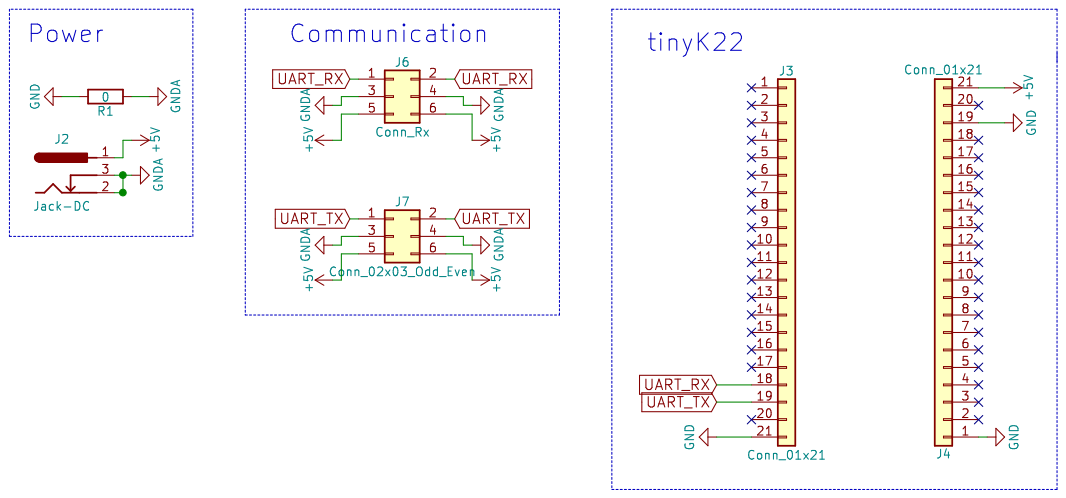
[picture p160: page 1]
