Scavenger18/RepoPNP/KiCad/1_H-Board/H-Bridge_Proto.kicad_pcb

## KiCad design KiCad/1_H-Board/H-Bridge_Proto.kicad_pcb (2018-03-06)

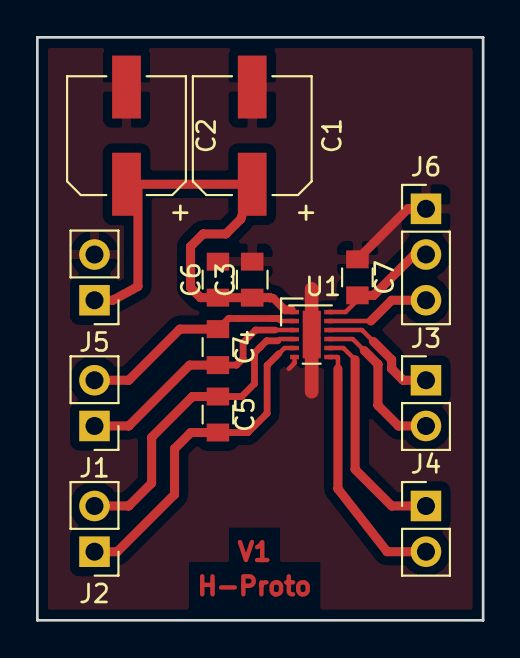
[picture p161: board H-Bridge_Proto.kicad_pcb from above]

Board: 2 copper layers, 24.8 x 32.4 mm, 14 parts (0 on the bottom side), 12 nets.

Parts:
C1, C2: 220u; CP_Elec_6.3x7.7
C3: 1u; C_0805
C4, C5: 3n3; C_0805
C6, C7: 100n; C_0805
J1, J2, J3, J4, J5: Conn_01x02; Pin_Header_Straight_1x02_Pitch2.54mm
J6: Conn_01x03; Pin_Header_Straight_1x03_Pitch2.54mm
U1: DRV8835; WSON-12-1EP_3x2mm_Pitch0.5mm

Connections:
+3V3: C7.2, J6.2, U1.12
+8V: C1.1, C2.1, C3.1, C6.1, J5.1, U1.1
/Dir_A: J3.1, U1.10
/Dir_B: J4.1, U1.8
/PWM_A: J3.2, U1.9
/PWM_B: J4.2, U1.7
GND: C1.2, C2.2, C3.2, C6.2, C7.1, J5.2, J6.1, U1.6, U1.13
unnamed: C4.1, J1.2, U1.2
unnamed: C4.2, J1.1, U1.3
unnamed: C5.1, J2.2, U1.4
unnamed: C5.2, J2.1, U1.5
unnamed: J6.3, U1.11
