Scavenger18/RepoPNP/KiCad/0_Enc_Board/Enc_Board.kicad_pcb

## KiCad design KiCad/0_Enc_Board/Enc_Board.kicad_pcb (2018-03-06)

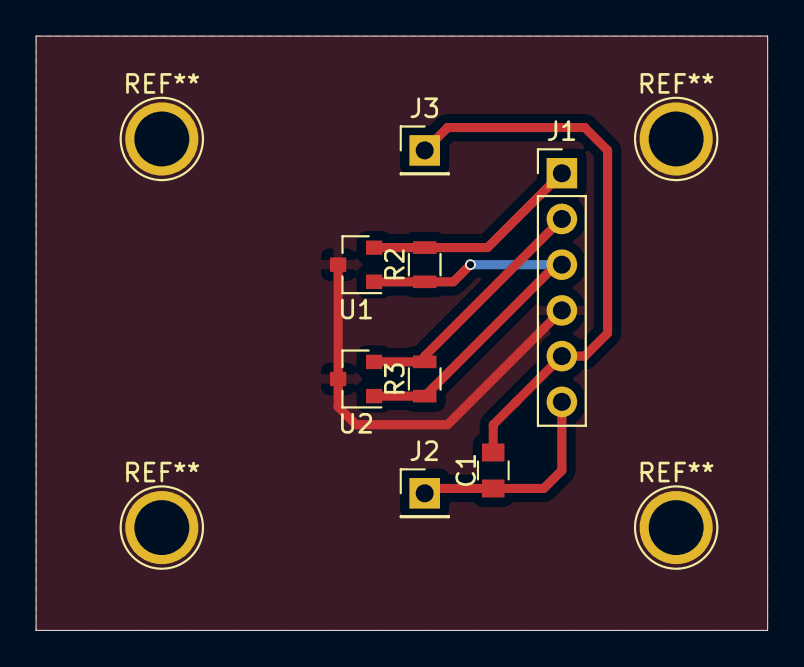
[picture p162: board Enc_Board.kicad_pcb from above]

Board: 2 copper layers, 40.6 x 33.0 mm, 8 parts (0 on the bottom side), 6 nets.

Parts:
C1: 3n3; C_0805
J1: Conn_01x06; Pin_Header_Straight_1x06_Pitch2.54mm
J2: Mot+; Pin_Header_Straight_1x01_Pitch2.54mm
J3: Mot-; Pin_Header_Straight_1x01_Pitch2.54mm
R2, R3: N/P; R_0805
U1, U2: DRV5013; SOT-23

Connections:
+3V3: J1.3, R2.1, R3.1, U1.1, U2.1
/Enc_L_A: J1.1, R2.2, U1.2
/Enc_L_B: J1.2, R3.2, U2.2
GND: J1.4, U1.3, U2.3
unnamed: C1.1, J1.6, J2.1
unnamed: C1.2, J1.5, J3.1
