Scavenger18/RepoPNP/(commit log)

2018-03-06 Added Encoder and H-Bridge KiCad projects
    [Enc_Board.kicad_pcb, H-Bridge_Proto.kicad_pcb, H-Bridge_Proto.sch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]
2018-03-06 Finished H-Bridge PCB V1
    [H-Bridge_Proto.kicad_pcb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]
2018-03-26 added datasheets and enc pcb
    [Sprocket_Enc.kicad_pcb, Sprocket_Enc.sch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]
2018-03-27 added datasheets
    [gg_gear_30.dxf]
2018-04-24 changed pins to PCB build
2018-05-29 added KiCad Projects
2018-05-29 added Init for Status-LED
2018-06-06 added Documentation
    [24mm_Spacer_1.stl, 24mm_Spacer_2.stl, BackWall_12MM.stl, BackWall_16MM.stl, BackWall_24MM.stl, BackWall_8MM.stl, Distance_16.stl, Distance_24.stl]
